OpenPanzerProject/TankIR/(threads)

Thread 1 (2018-01-24):

Additional feature

sateng, 2018-01-24:
Hello!
A nice additional Feature to this project would be the addition of a servo controlled gun traverse with optional speed control.
So you could pan the artillery slowly and fire it with your rc controller.

OpenPanzerProject, 2018-01-25:
Response left in the RC Universe thread where this question was originally posed: [CLICK HERE](https://www.rctankwarfare.co.uk/forums/viewtopic.php?p=231846#p231846)

Closed 2018-01-25.
