OpenPanzerProject/TankIR/TankIR_Schematic.pdf

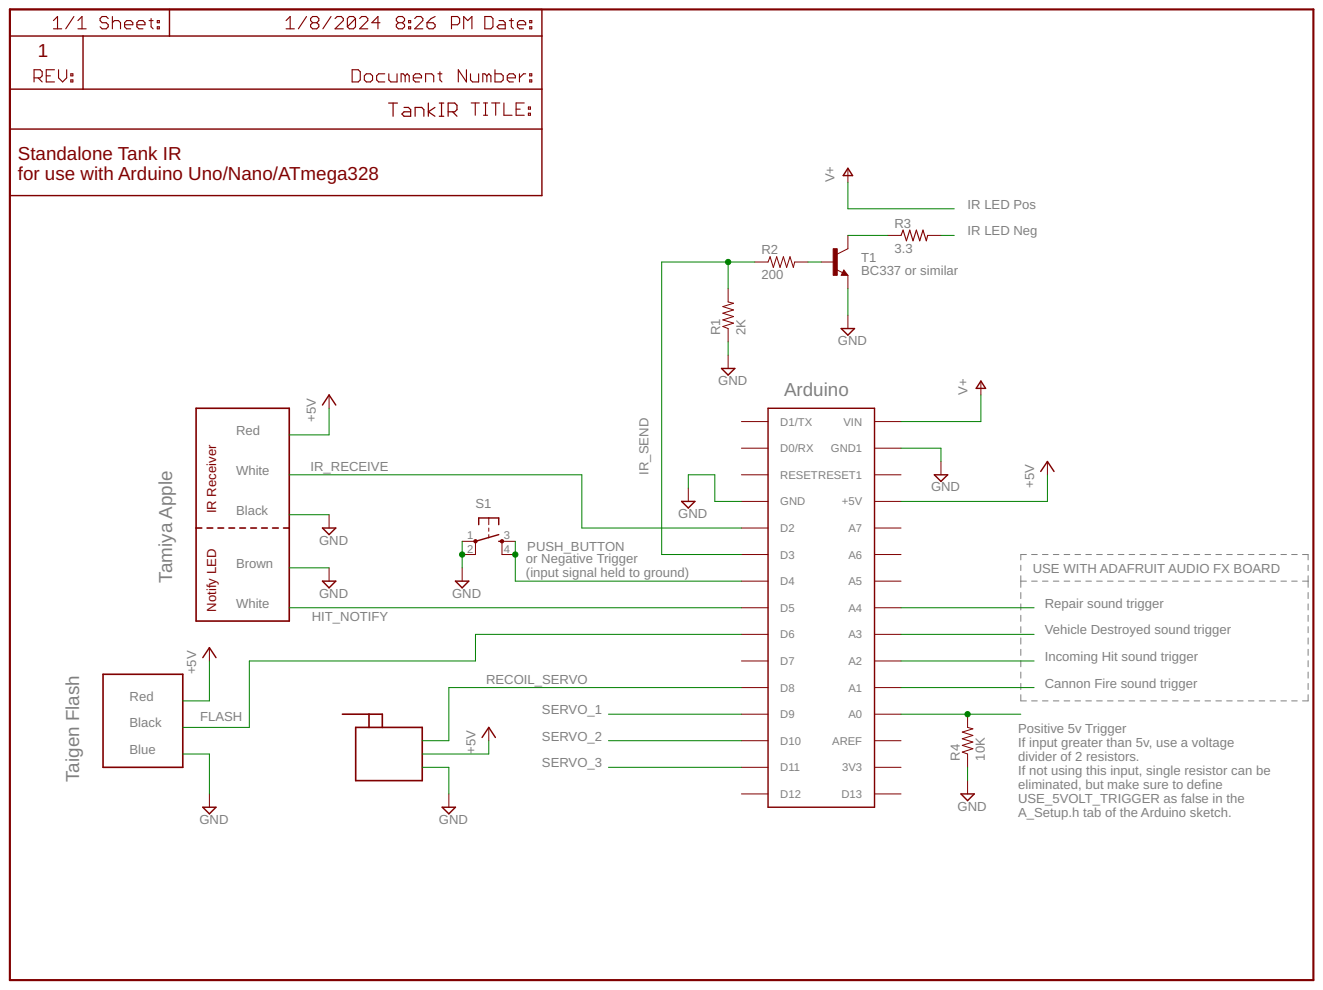
[picture p1: page 1]

Standalone Tank IR
for use with Arduino Uno/Nano/ATmega328

PUSH_BUTTON
or Negative Trigger
(input signal held to ground)

Incoming Hit sound trigger Vehicle Destroyed sound trigger Repair sound trigger USE WITH ADAFRUIT AUDIO FX BOARD

Cannon Fire sound trigger

Positive 5v Trigger
If input greater than 5v, use a voltage
divider of 2 resistors.
If not using this input, single resistor can be
eliminated, but make sure to define USE_5VOLT_TRIGGER as false in the A_Setup.h tab of the Arduino sketch.
