OpenPanzerProject/TankIR/(commit log)

2017-01-18 Add schematic
2017-01-19 Upload schematic
2017-01-19 Update schematic
2017-01-19 Add second cannon trigger, this one for positive voltage
2017-01-19 Added Taigen flash wiring.
2017-03-28 Slight re-wording to avoid some compiler errors with Linux, code functionality remains the same.
    [IRLib.cpp, Settings.h, TankIR.ino]
2017-08-14 Add pin outputs to trigger sounds on an external device such as the Adafruit Audio FX boards.
2021-03-17 Increase repetitions of the Tamiya IR signal from 10 to 50 (1/5 of a second to 1 second). Tamiya repeats the signal 50 times which takes 1 second. This is overkill and makes possible the infamous "fa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
2021-03-17 Minor fixes to avoid compiler warnings.
    [Button.cpp, Button.h, IRLib.cpp, IRLib.h, IRLibMatch.h, Motors.cpp, Servo.h, Tank.cpp]
2024-01-06 Add option to blink IR apple notification LEDs briefly when the cannon reload time has completed.
2024-01-06 Add a notice about resistor requirement on pin A0.
2024-01-06 Update sample schematic with clarified instructions.
2024-01-08 Allow the option to disable the positive 5V trigger, otherwise if unused it can cause phantom firing. Also fix a mistake in the implementation of the cannon reloaded notification blink. Update sample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
    [A_Setup.h, Cannon.ino, Tank.cpp, TankIR.ino]
2024-01-08 Fix bug that permitted the cannon to fire even while destroyed (ie, during the DESTROYED_INOPERATIVE_TIME_mS). While destroyed, the cannon should not be able to fire.
    [Cannon.ino, Tank.cpp]
